yurec-orl/Niva_dashboard_rpi/niva_dashboard/src/hardware/sensor_manager.rs

//! Sensor Manager implements a sensor management system using a chain-of-responsibility
//! pattern to handle sensor data from raw hardware inputs to logical values.
//!
//! The system is built around three-stage processing chains:
//!
//! Hardware Provider → Signal Processors → Logical Sensor
//!     (Raw Data)      (Filtering/Smoothing)  (Value Conversion)
//!
//! ### Components
//!
//! 1. **Hardware Providers** (`HWDigitalProvider`/`HWAnalogProvider`)
//!    - Abstract hardware interface layer
//!    - Read raw sensor data from GPIO pins, I2C devices, or test data
//!    - Return unprocessed digital levels (High/Low) or analog values (u16)
//!
//! 2. **Signal Processors** (`DigitalSignalProcessor`/`AnalogSignalProcessor`)
//!    - Pipeline of configurable processing stages
//!    - Digital: debouncing, edge detection, state smoothing
//!    - Analog: moving averages, low-pass filtering, noise reduction
//!    - Multiple processors can be chained for complex signal conditioning
//!
//! 3. **Logical Sensors** (`DigitalSensor`/`AnalogSensor`)
//!    - Convert processed signals to meaningful values
//!    - Digital: map to boolean states (active/inactive) considering polarity
//!    - Analog: convert to physical units (voltage → temperature, ADC → fuel level)
//!
//! ### Sensor Chains
//!
//! **SensorDigitalInputChain**: Hardware → [Processors] → Digital Sensor → bool
//! - Example: GPIO pin → debounce → active-low interpretation → brake_engaged
//!
//! **SensorAnalogInputChain**: Hardware → [Processors] → Analog Sensor → f32
//! - Example: ADC → moving average → voltage divider math → fuel_percentage
//!
//! ### SensorManager
//!
//! - Maintains collections of configured sensor chains
//! - Routes read requests to appropriate chains by input type
//! - Executes the full processing pipeline for each sensor read
//! - Returns processed, ready-to-display values to the UI layer
//!
//! ### Usage
//!
//! ```rust
//! let mut manager = SensorManager::new();
//! 
//! // Configure a digital sensor chain
//! let chain = SensorDigitalInputChain::new(
//!     Box::new(gpio_provider),
//!     vec![Box::new(debouncer)],
//!     Box::new(active_low_sensor)
//! );
//! manager.add_digital_sensor_chain(chain);
//! 
//! // Read processed sensor value
//! let brake_active = manager.read_digital_sensor(HWInput::ParkBrake(Level::Low))?;
//! ```

use crate::hardware::sensors::{AnalogSensor, DigitalSensor};
use crate::hardware::hw_providers::{HWInput, HWAnalogProvider, HWDigitalProvider, ADCChannelProvider};
use crate::hardware::analog_signal_processing::AnalogSignalProcessor;
use crate::hardware::digital_signal_processing::DigitalSignalProcessor;
use crate::hardware::sensor_value::SensorValue;
use crate::util::adc_data_provider::ADCFrame;

use std::collections::HashMap;

// Sensor management - chains hardware providers, signal processors, and logical sensors
pub struct SensorDigitalInputChain {
    hw_provider: Box<dyn HWDigitalProvider + Send>,
    // Signal processors are applied in sequence
    signal_processors: Vec<Box<dyn DigitalSignalProcessor + Send>>,
    sensor: Box<dyn DigitalSensor + Send>,
}

impl SensorDigitalInputChain {
    pub fn new(
        hw_provider: Box<dyn HWDigitalProvider + Send>,
        signal_processors: Vec<Box<dyn DigitalSignalProcessor + Send>>,
        sensor: Box<dyn DigitalSensor + Send>,
    ) -> Self {
        SensorDigitalInputChain {
            hw_provider,
            signal_processors,
            sensor,
        }
    }
}

// Analog sensor input chain, similar to SensorDigitalInputChain
pub struct SensorAnalogInputChain {
    hw_provider: Box<dyn HWAnalogProvider + Send>,
    // Signal processors are applied in sequence
    signal_processors: Vec<Box<dyn AnalogSignalProcessor + Send>>,
    sensor: Box<dyn AnalogSensor + Send>,
}

impl SensorAnalogInputChain {
    pub fn new(
        hw_provider: Box<dyn HWAnalogProvider + Send>,
        signal_processors: Vec<Box<dyn AnalogSignalProcessor + Send>>,
        sensor: Box<dyn AnalogSensor + Send>,
    ) -> Self {
        SensorAnalogInputChain {
            hw_provider,
            signal_processors,
            sensor,
        }
    }
}

pub struct SensorManager {
    digital_sensors: Vec<SensorDigitalInputChain>,
    analog_sensors: Vec<SensorAnalogInputChain>,
    sensor_values: HashMap<HWInput, SensorValue>,
    // Optional handle to the shared ADC frame, set by callers whose chains include
    // ADCChannelProviders. Lets adc_link_down() report link status directly from the
    // transport layer rather than through a chain read, since a chain read is exactly
    // what fails (with "channel not in frame") while the link is down.
    adc_frame: Option<ADCFrame>,
}

impl SensorManager {
    pub fn new() -> Self {
        SensorManager {
            digital_sensors: Vec::new(),
            analog_sensors: Vec::new(),
            sensor_values: HashMap::new(),
            adc_frame: None,
        }
    }

    pub fn add_digital_sensor_chain(&mut self, chain: SensorDigitalInputChain) {
        self.digital_sensors.push(chain);
    }

    pub fn add_analog_sensor_chain(&mut self, chain: SensorAnalogInputChain) {
        self.analog_sensors.push(chain);
    }

    /// Inserts a value computed outside any registered chain -- e.g. HeadingFusionSensor,
    /// which reads GnssFrame/Bno085Frame directly rather than through a HWAnalogProvider
    /// (see heading_fusion_sensor.rs for why) -- into the same map every chain-backed
    /// reading lands in, so get_sensor_value/get_sensor_values don't need to know how a
    /// given HWInput's value was produced.
    pub fn set_external_value(&mut self, input: HWInput, value: SensorValue) {
        self.sensor_values.insert(input, value);
    }

    /// Registers the ADC frame this manager's chains read from, so adc_link_down() can
    /// report connectivity. Only needed when chains include ADCChannelProviders.
    pub fn set_adc_frame(&mut self, frame: Option<ADCFrame>) {
        self.adc_frame = frame;
    }

    /// Points every chain whose `HWInput` is ADC-backed (`HWInput::adc_channel().is_some()`
    /// -- the same predicate `ADCChannelProvider::new` itself uses) at a fresh
    /// `ADCChannelProvider` reading `frame` instead of whatever frame it was reading before,
    /// leaving every other chain (UPS, GNSS, BNO085, master warning, link-health,
    /// one-wire-temp) completely untouched.
    ///
    /// This is how bench test mode (`PageManager::toggle_bench_test_mode`) swaps in
    /// synthetic sensor data without rebuilding the manager: call once with a synthetic
    /// settle-mode frame to enter bench mode, and again with the real frame to leave it --
    /// same function, same manager, both directions. Doesn't touch `adc_frame` (see
    /// `set_adc_frame`); callers that want `adc_link_down()` to track the new frame too
    /// must call that separately.
    pub fn redirect_adc_chains(&mut self, frame: ADCFrame) {
        for chain in &mut self.digital_sensors {
            let input = chain.hw_provider.input();
            if input.adc_channel().is_some() {
                chain.hw_provider = Box::new(ADCChannelProvider::new(input, frame.clone()));
            }
        }
        for chain in &mut self.analog_sensors {
            let input = chain.hw_provider.input();
            if input.adc_channel().is_some() {
                chain.hw_provider = Box::new(ADCChannelProvider::new(input, frame.clone()));
            }
        }
    }

    /// True if this manager depends on the ADC link and that link is currently down.
    /// Used by callers to suppress read-error logging for the "channel not in frame"
    /// errors that are the expected, transient result of the ADC being disconnected —
    /// see AdcDataProvider's reconnect loop, which recovers automatically.
    pub fn adc_link_down(&self) -> bool {
        self.adc_frame.as_ref().is_some_and(|frame| frame.is_stale())
    }

    fn read_digital_sensor(&mut self, input: HWInput) -> Result<SensorValue, String> {
        for chain in &mut self.digital_sensors {
            if chain.hw_provider.input() != input {
                continue;
            }
            // Read raw input from hardware provider
            let mut level = chain.hw_provider.read_digital(input)?;
            
            // Process through signal processors
            for processor in &mut chain.signal_processors {
                level = processor.read(level)?;
            }
            
            // Convert to logical sensor value
            return Ok(chain.sensor.read(level)?.clone());
        }
        Err(format!("Digital sensor chain not found for input: {:?}", input))
    }

    fn read_analog_sensor(&mut self, input: HWInput) -> Result<SensorValue, String> {
        for chain in &mut self.analog_sensors {
            if chain.hw_provider.input() != input {
                continue;
            }
            // Read raw input from hardware provider
            let mut value = chain.hw_provider.read_analog(input)?;
            
            // Process through signal processors
            for processor in &mut chain.signal_processors {
                value = processor.read(value)?;
            }
            
            // Convert to logical sensor value
            return Ok(chain.sensor.read(value)?.clone());
        }
        Err("Analog sensor chain not found".to_string())
    }

    // Should be called periodically from event loop to update all sensors
    //
    // Chains are read independently — one chain failing (e.g. a GNSS field with no current
    // fix, which is routine and can persist indefinitely) must not prevent every other,
    // unrelated chain from updating. Previously this used `?` per read, which aborted the
    // whole cycle on the first failure; since sensor_values is cleared up front, that meant
    // every chain ordered after the failing one lost its value for the entire cycle (see
    // niva_dashboard's GNSS integration, which surfaced this — GNSS chains fail far more
    // routinely than the ADC ones this originally worked fine with).
    pub fn read_all_sensors(&mut self) -> Result<(), String> {
        self.sensor_values.clear();

        // Collect inputs first to avoid borrowing issues
        let digital_inputs: Vec<HWInput> = self.digital_sensors.iter()
            .map(|chain| chain.hw_provider.input())
            .collect();
        let analog_inputs: Vec<HWInput> = self.analog_sensors.iter()
            .map(|chain| chain.hw_provider.input())
            .collect();

        // Last error is reported to the caller (for logging) but never stops the loop —
        // every remaining chain still gets a chance to update sensor_values.
        let mut last_error: Option<String> = None;

        for input in digital_inputs {
            match self.read_digital_sensor(input) {
                Ok(value) => { self.sensor_values.insert(input, value); }
                Err(e) => last_error = Some(e),
            }
        }

        for input in analog_inputs {
            match self.read_analog_sensor(input) {
                Ok(value) => { self.sensor_values.insert(input, value); }
                Err(e) => last_error = Some(e),
            }
        }

        match last_error {
            Some(e) => Err(e),
            None => Ok(()),
        }
    }

    pub fn get_sensor_values(&self) -> &HashMap<HWInput, SensorValue> {
        &self.sensor_values
    }

    pub fn get_sensor_value(&self, input: &HWInput) -> Option<&SensorValue> {
        self.sensor_values.get(input)
    }
}

#[cfg(test)]
mod tests {
    use super::*;
    use crate::hardware::hw_providers::{TestDigitalDataProvider, TestAnalogDataProvider};
    use crate::hardware::digital_signal_processing::DigitalSignalDebouncer;
    use crate::hardware::analog_signal_processing::AnalogSignalProcessorMovingAverage;
    use crate::hardware::sensors::{GenericDigitalSensor, GenericAnalogSensor};
    use crate::hardware::sensor_value::ValueConstraints;
    use crate::util::adc_data_provider::TestADCDataProvider;
    use rppal::gpio::Level;

    /// Always-failing analog provider, standing in for e.g. GnssChannelProvider reading a
    /// field that's simply not present in the current fix yet — a routine, expected failure
    /// mode that must not block unrelated chains from updating.
    struct AlwaysFailingAnalogDataProvider {
        input: HWInput,
    }

    impl crate::hardware::hw_providers::HWAnalogProvider for AlwaysFailingAnalogDataProvider {
        fn input(&self) -> HWInput { self.input }
        fn read_analog(&self, _input: HWInput) -> Result<u16, String> {
            Err("simulated read failure".to_string())
        }
    }
    use std::time::Duration;

    #[test]
    fn test_sensor_manager_digital_chain() {
        log::info!("=== Testing Digital Sensor Chain ===");
        
        let mut manager = SensorManager::new();
        
        // Create test digital input for park brake (active low)
        let park_brake_input = HWInput::HwParkBrake;
        
        // Create digital sensor chain components
        let hw_provider = Box::new(TestDigitalDataProvider::new(park_brake_input));
        let debouncer = Box::new(DigitalSignalDebouncer::new(3, Duration::from_millis(50)));
        let sensor = Box::new(GenericDigitalSensor::new("test_park_brake".to_string(), "Test Park Brake".to_string(), 
                                                        Level::Low, ValueConstraints::digital_warning())); // Active low sensor
        
        // Create and add the chain
        let chain = SensorDigitalInputChain::new(
            hw_provider,
            vec![debouncer],
            sensor,
        );
        manager.add_digital_sensor_chain(chain);
        
        // Test reading the sensor during active period (first 4 seconds)
        let result = manager.read_digital_sensor(park_brake_input);
        assert!(result.is_ok(), "Digital sensor read should succeed");
        
        let sensor_value = result.unwrap();
        log::info!("Park brake active (during active period): {}", sensor_value.is_active());
        
        // In TestDigitalDataProvider, the first 4 seconds return the active level (Low)
        // Since our sensor is active-low, it should read as true (active)
        assert!(sensor_value.is_active(), "Park brake should be active during test period");
        
        log::info!("✓ Digital sensor chain test passed");
    }

    #[test]
    fn test_sensor_manager_analog_chain() {
        log::info!("=== Testing Analog Sensor Chain ===");
        
        let mut manager = SensorManager::new();
        
        // Create test analog input for fuel level
        let fuel_input = HWInput::HwFuelLvl;
        
        // Create analog sensor chain components
        let hw_provider = Box::new(TestAnalogDataProvider::new(fuel_input));
        let moving_avg = Box::new(AnalogSignalProcessorMovingAverage::new(3));
        let sensor = Box::new(GenericAnalogSensor::new(
            "test_fuel".to_string(), "Test Fuel Level".to_string(), "%".to_string(),
            ValueConstraints::analog_with_thresholds(0.0, 100.0, Some(10.0), Some(20.0), None, None),
            1.0
        ));
        
        // Create and add the chain
        let chain = SensorAnalogInputChain::new(
            hw_provider,
            vec![moving_avg],
            sensor,
        );
        manager.add_analog_sensor_chain(chain);
        
        // Test reading the sensor
        let result = manager.read_analog_sensor(fuel_input);
        assert!(result.is_ok(), "Analog sensor read should succeed");
        
        let sensor_value = result.unwrap();
        log::info!("Fuel level: {:.1}%", sensor_value.as_f32());
        
        // Fuel percentage should be between 0 and 100
        let fuel_percentage = sensor_value.as_f32();
        assert!(fuel_percentage >= 0.0 && fuel_percentage <= 100.0, 
               "Fuel percentage should be between 0 and 100");
        
        log::info!("✓ Analog sensor chain test passed");
    }

    /// Always-erroring provider standing in for "whatever provider a real build originally
    /// wired up" -- if `redirect_adc_chains` did nothing, reads would keep failing.
    struct AlwaysErrAnalogProvider(HWInput);
    impl HWAnalogProvider for AlwaysErrAnalogProvider {
        fn input(&self) -> HWInput { self.0 }
        fn read_analog(&self, _input: HWInput) -> Result<u16, String> {
            Err("should have been replaced by redirect_adc_chains".to_string())
        }
    }

    #[test]
    fn test_redirect_adc_chains_only_touches_adc_backed_inputs() {
        let mut manager = SensorManager::new();

        // HwOilPress has an ADC channel mapping (HWInput::adc_channel) -- redirect_adc_chains
        // must replace its provider.
        manager.add_analog_sensor_chain(SensorAnalogInputChain::new(
            Box::new(AlwaysErrAnalogProvider(HWInput::HwOilPress)),
            vec![],
            Box::new(GenericAnalogSensor::new("oil".to_string(), "Oil".to_string(), "".to_string(),
                ValueConstraints::analog(0.0, 1023.0), 1.0)),
        ));
        // HwGnssSpeed has no ADC channel mapping -- must be left completely alone.
        manager.add_analog_sensor_chain(SensorAnalogInputChain::new(
            Box::new(TestAnalogDataProvider::new(HWInput::HwGnssSpeed)),
            vec![],
            Box::new(GenericAnalogSensor::new("gnss".to_string(), "GNSS".to_string(), "".to_string(),
                ValueConstraints::analog(0.0, 200.0), 1.0)),
        ));

        let provider = TestADCDataProvider::start();
        let frame = provider.frame();
        std::thread::sleep(Duration::from_millis(50));

        manager.redirect_adc_chains(frame);

        assert!(manager.read_analog_sensor(HWInput::HwOilPress).is_ok(),
            "ADC-backed chain must now read through the new frame instead of erroring");
        assert!(manager.read_analog_sensor(HWInput::HwGnssSpeed).is_ok(),
            "non-ADC-backed chain must be untouched (still its own TestAnalogDataProvider)");
    }

    #[test]
    fn test_sensor_manager_multiple_chains() {
        log::info!("=== Testing Multiple Sensor Chains ===");
        
        let mut manager = SensorManager::new();
        
        // Add digital chain for high beam indicator (active high)
        let high_beam_input = HWInput::HwHighBeam;
        let digital_chain = SensorDigitalInputChain::new(
            Box::new(TestDigitalDataProvider::new(high_beam_input)),
            vec![], // No signal processing for this test
            Box::new(GenericDigitalSensor::new("test_high_beam".to_string(), "Test High Beam".to_string(),
                                              Level::High, ValueConstraints::digital_default())), // Active high sensor
        );
        manager.add_digital_sensor_chain(digital_chain);
        
        // Add analog chain for temperature
        let temp_input = HWInput::HwEngineCoolantTemp;
        let analog_chain = SensorAnalogInputChain::new(
            Box::new(TestAnalogDataProvider::new(temp_input)),
            vec![Box::new(AnalogSignalProcessorMovingAverage::new(5))],
            Box::new(GenericAnalogSensor::new(
                "test_temp".to_string(), "Test Temperature".to_string(), "°C".to_string(),
                ValueConstraints::analog_with_thresholds(-40.0, 120.0, Some(-20.0), Some(0.0), Some(100.0), Some(110.0)),
                1.0
            )),
        );
        manager.add_analog_sensor_chain(analog_chain);
        
        // Test both sensors
        let high_beam_result = manager.read_digital_sensor(high_beam_input);
        let temp_result = manager.read_analog_sensor(temp_input);
        
        assert!(high_beam_result.is_ok(), "High beam sensor should work");
        assert!(temp_result.is_ok(), "Temperature sensor should work");
        
        let high_beam_sensor_value = high_beam_result.unwrap();
        let temp_sensor_value = temp_result.unwrap();
        
        log::info!("High beam active: {}", high_beam_sensor_value.is_active());
        log::info!("Temperature: {:.1}°C", temp_sensor_value.as_f32());
        
        // Validate ranges
        let temperature = temp_sensor_value.as_f32();
        assert!(temperature >= -40.0 && temperature <= 120.0, 
               "Temperature should be within sensor range");
        
        log::info!("✓ Multiple sensor chains test passed");
    }

    #[test]
    fn test_sensor_manager_nonexistent_chain() {
        log::info!("=== Testing Non-existent Sensor Chain ===");
        
        let mut manager = SensorManager::new();
        
        // Try to read from a sensor that wasn't configured
        let non_existent_input = HWInput::HwSpeed;
        let result = manager.read_digital_sensor(non_existent_input);
        
        assert!(result.is_err(), "Reading non-existent sensor should fail");
        
        let error_msg = result.unwrap_err();
        log::error!("Expected error: {}", error_msg);
        assert!(error_msg.contains("Digital sensor chain not found"), 
               "Error should indicate missing chain");
        
        log::info!("✓ Non-existent sensor chain test passed");
    }

    #[test] 
    fn test_sensor_manager_signal_processing_pipeline() {
        log::info!("=== Testing Signal Processing Pipeline ===");
        
        let mut manager = SensorManager::new();
        
        // Create a chain with multiple signal processors
        let turn_signal_input = HWInput::HwTurnSignal;
        
        // Add two debounce stages for extra filtering
        let debouncer1 = Box::new(DigitalSignalDebouncer::new(2, Duration::from_millis(25)));
        let debouncer2 = Box::new(DigitalSignalDebouncer::new(2, Duration::from_millis(25)));
        
        let chain = SensorDigitalInputChain::new(
            Box::new(TestDigitalDataProvider::new(turn_signal_input)),
            vec![debouncer1, debouncer2], // Multiple processors in sequence
            Box::new(GenericDigitalSensor::new("test_turn_signal".to_string(), "Test Turn Signal".to_string(),
                                              Level::High, ValueConstraints::digital_default())),
        );
        manager.add_digital_sensor_chain(chain);
        
        // Read the sensor to verify the pipeline works
        let result = manager.read_digital_sensor(turn_signal_input);
        assert!(result.is_ok(), "Signal processing pipeline should work");
        
        let sensor_value = result.unwrap();
        log::info!("Turn signal active (after processing): {}", sensor_value.is_active());
        
        log::info!("✓ Signal processing pipeline test passed");
    }

    #[test]
    fn test_read_all_sensors_one_failing_chain_does_not_block_others() {
        log::info!("=== Testing read_all_sensors resilience to a single chain failure ===");

        let mut manager = SensorManager::new();

        // Ordered first, deliberately, so a pre-fix (abort-on-first-error) read_all_sensors
        // would never even attempt the chain below.
        let failing_chain = SensorAnalogInputChain::new(
            Box::new(AlwaysFailingAnalogDataProvider { input: HWInput::HwGnssMovingHeading }),
            vec![],
            Box::new(GenericAnalogSensor::new("failing".to_string(), "Failing".to_string(), "".to_string(),
                                              ValueConstraints::analog(0.0, 100.0), 1.0)),
        );
        manager.add_analog_sensor_chain(failing_chain);

        let working_chain = SensorAnalogInputChain::new(
            Box::new(TestAnalogDataProvider::new(HWInput::HwFuelLvl)),
            vec![],
            Box::new(GenericAnalogSensor::new("working".to_string(), "Working".to_string(), "%".to_string(),
                                              ValueConstraints::analog(0.0, 100.0), 1.0)),
        );
        manager.add_analog_sensor_chain(working_chain);

        let result = manager.read_all_sensors();
        assert!(result.is_err(), "the failing chain's error should still surface");

        assert!(manager.get_sensor_value(&HWInput::HwGnssMovingHeading).is_none(),
               "the failing chain should simply have no value, not poison the cycle");
        assert!(manager.get_sensor_value(&HWInput::HwFuelLvl).is_some(),
               "a chain ordered after a failing one must still be read");

        log::info!("✓ read_all_sensors resilience test passed");
    }

}
