yurec-orl/Niva_dashboard_rpi/(commit log)

2025-08-29 Text renderer cleanup fix
    [context.rs]
2025-08-30 Add input handlers for external keyboard and MFI buttons
2025-08-30 Fix text rendering y coordinate (top line instead of a baseline)
    [context.rs]
2025-08-30 Add current page
2025-08-30 Add button labels rendering
2025-08-31 Add sensors reading framework - WIP
2025-08-31 Use page id for switch_page
2025-09-02 Hardware input reading and processing framework - implementation
2025-09-06 Add sensor manager
2025-09-06 Add sensor manager tests
2025-09-07 Add unit tests, fix compilation errors
    [mod.rs, page_manager.rs, ui_style.rs]
2025-09-07 Replace color manager with UIStyle
    [context.rs, mod.rs, page_manager.rs, ui_style.rs]
2025-09-07 Improve text rendering framework
2025-09-07 Add diag page with page switching
2025-09-12 WIP - indicator rendering framework
2025-09-12 Add basic text indicators using sensors and ui style framework
2025-09-14 WIP: sensor framework refactoring
2025-09-14 Refactor sensors framework - simplified interface, unified digital and analog HWInputs, combined all sensor output values in one vector
2025-09-19 Add constraints and metadata to sensor objects
2025-09-19 Fix unit test compilation errors
    [sensor_manager.rs]
2025-09-19 Add sensors unit tests
2025-09-20 Refactor sensor framework
2025-09-24 Add vertical text orientation for page button labels
2025-09-25 Improve event system - switch to dual-channel
2025-09-27 Add alerts framework (WIP)
2025-09-28 Add alerts framework
2025-12-18 Change watchdogs suppress timers
2025-12-18 Improve button labels rendering (fix #5)
    [page_manager.rs]
2025-12-18 Add indicator position tests (fix #6)
    [hw_providers.rs, main.rs, opengl_test.rs, run_test.rs]
2026-03-14 Add sketch for Arduino ADC module
2026-03-14 Add buttons reading to arduino module
2026-03-15 Add pin mapping for STM32 based ADC-sensor module
2026-03-15 Add wiring doc
2026-05-24 Refactor ui style framework and brightness handling
2026-05-24 Remove manual frame timing, fix rendered vsync bug
    [context.rs, page_manager.rs]
2026-05-30 Update STM32 module
2026-06-09 Add ADC module firmware
2026-06-14 Fix gl buffers leak
    [context.rs, opengl_test.rs, page_manager.rs, run_test.rs]
2026-06-14 Fix gauge marks horisontal position
    [opengl_test.rs, page_manager.rs]
2026-06-14 Add script for testing ADC output
2026-06-21 Add sensor manager swapping, improve adc_data_provider
    [adc_data_provider.rs, adc_serial_reader.rs, events.rs, main.rs, page_manager.rs, sensor_manager.rs]
2026-06-21 Add ADC hardware sensors and manager
2026-07-04 Add shutdown handling and auto-restart on errors or rebuild
    [input.rs, main.rs, mod.rs, page_manager.rs, shutdown.rs]
2026-07-04 Add button backlight redesign plan
2026-07-12 Fix buttons pin mapping
    [main.cpp]
2026-07-12 Add physical buttons input handling from ADC module
2026-07-12 Add ADC link error alert
    [adc_data_provider.rs, adc_serial_reader.rs, hw_providers.rs, main.rs, page_manager.rs]
2026-07-12 Add ADC serial port reconnect
2026-07-12 Add power-cycling ADC module if its unresponsive
2026-07-12 Add automatic shutdown/startup from external power
2026-07-12 Fix alerts suppression logic
    [page_manager.rs]
2026-07-22 Display UPS charge/discharge current
2026-07-22 Add scrolling text box renderer and program log/adc data display
2026-07-22 Add UPS charge level, change status font
2026-07-28 Add on battery power log message
2026-07-28 Add reboot button to diag page
    [diag_page.rs, page_manager.rs, ups_monitor.rs]
2026-07-28 Refactor ups monitor to use sensors framework; add ups alerts
2026-07-29 Add gnss sensors
2026-07-30 Add speed sensor averaging
2026-08-01 Replace speed pulse counting with time between pulses counting
    [main.cpp]
2026-08-01 Replace tacho pulse counting with period counting
    [main.cpp]
2026-08-01 Change on battery threshold
2026-08-01 Fix tachometer sensor
2026-08-01 Refactor adc channels numbering
2026-08-01 Refactor adc provider construction
2026-08-01 Fix speed and tacho sensors
    [sensors.rs]
2026-08-08 Add BNO085 support and gnss/bno085 sensors test mode
2026-08-09 Add fused heading provider for gnss page heading indicator
2026-08-09 Add fused heading sensor based on inertial and gnss data
2026-08-11 Adjust shutdown timer for ups power off timer
2026-08-12 Add IMU info block to gnss page
2026-08-12 Add button press indication
2026-08-12 Fix heading accuracy indication
    [gnss_page.rs, heading_fusion_sensor.rs]
2026-08-12 Add button press event handling and manual heading override for gnss page
2026-08-13 Rearrange main page buttons
2026-08-13 Add pitch/roll indicators; fix BNO085 pitch direction; fix text height calculations
    [bno085_protocol.rs, context.rs, horz_page.rs, main_page.rs, mod.rs]
2026-08-13 Add calibration to horz page
2026-08-13 Improve pitch roll calibration
2026-08-14 Add OSC mode implementation to STM32
2026-08-14 Add osc mode test; fix STM32 osc firmware bug
    [main.cpp, main.rs, run_test.rs]
2026-08-14 Fix osc volts conversion
    [osc_page.rs]
2026-08-25 Add master warning button/led
2026-08-25 Change heading sensor PersistedPrior handling logic
2026-08-25 Improve BNO085 error handling
    [bno085_protocol.rs]
2026-08-26 Refactor bno frame calibration logic
2026-08-26 Refactor bno/gnss frame link status
2026-08-26 Change test to fail - testing github workflow
    [heading_fusion_sensor.rs]
2026-08-26 Switch CI to ARM64 runner to match Pi's char signedness ABI
    The raw gl:: FFI calls pass byte-string pointers (*const u8) into
    parameters typed *const i8, relying on c_char being unsigned. That
    holds on ARM (the actual deploy target) but not x86_64, so it only
    ever compiled because it was only ever built on the Pi. Running CI
    on ubuntu-24.04-arm matches that ABI and tests the same architecture
    family the dashboard ships on.
2026-08-30 Create temp sensors design
2026-09-06 Add DS18B20 support to ADC
2026-09-06 Add sensors config and data-driven construction
2026-09-06 Add temperature sensors framework
2026-09-06 Improve sensor config error handling
    [main.rs, shutdown.rs]
2026-09-06 Add sensor calibration design doc
2026-09-06 Update sensor calibration design
2026-09-07 Add VoltageDividerSensor
2026-09-07 Fix USB CDC build settings (avoid deadlock on receiving commands - see diagnosis doc)
    [main.cpp]
2026-09-07 Add ADC firmware version report to diag page
2026-09-07 Adjust indicators construction to match sensors
2026-09-07 Calibrate 12V sensor
2026-09-08 Add calibrated sensor and calibration curves for oil, fuel, engine.
2026-09-08 Pin ADCCLK <= 14 MHz on the HSI-fallback clock tree
    When the 8 MHz HSE crystal doesn't start, the stm32duino clock config falls
    back to an HSI-PLL SYSCLK of 48 MHz with PCLK2 = 48 MHz but leaves ADCPRE at
    /2, clocking ADC1 at 24 MHz — ~71% over the STM32F103's 14 MHz maximum,
    which degrades conversion accuracy.
    configure_adc_clock(), called from setup(), selects the smallest ADCPRE
    divisor that keeps ADCCLK within spec for whatever PCLK2 actually booted:
    12 MHz at PCLK2 = 48, 12 MHz at a healthy 72.
    Verified against live $OSCDBG register dumps: rcc_cfgr ADCPRE 00 -> 01,
    adcclk 24 MHz -> 12 MHz. Lowering ADCCLK shifts raw ADC readings slightly,
    so the analog-channel trims in niva_dashboar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
    [main.cpp]
2026-09-08 Pair each main-page indicator with its HWInput explicitly
    Replace the three index-zipped Vecs in IndicatorSet (indicators, inputs,
    indicator_bounds) with a single Vec<IndicatorEntry>, each entry binding one
    indicator to the hardware input that feeds it and its screen bounds. A
    construction reorder can no longer desync the lists.
    The test-indicator setup no longer keeps a standalone 16-element input list in
    lockstep with 16 separate push calls: digital and analog inputs are zipped with
    their indicators at construction, and each analog sensor's decimal precision sits
    next to its own input.
    Closes #17
    [main_page.rs]
2026-09-12 Improve indicators rendering when sensor returns error
    [gnss_page.rs, horz_page.rs, main_page.rs, sensor_value.rs]
2026-09-12 Add sensor calibration framework and UI (single offset value per sensor)
2026-09-12 Add sustained test mode for adc data
2026-09-13 Adjust 12v trim value
2026-09-16 Add tachometer gauge, replace speedometer on main page set 1
    [adc_data_provider.rs, main_page.rs, mod.rs, sensors.rs]
2026-09-16 Add adc frame logging
2026-09-17 Fix analog sensors reading logic
    [adc_data_provider.rs, sensor_config.rs, sensors.rs]
2026-10-01 Add battery monitor (coulometer) preliminary design
2026-10-04 Adjust gnss anchor logic deviation tolerance
    [heading_fusion_sensor.rs]
2026-10-05 Fix heading anchoring logic and test
    [heading_fusion_sensor.rs]
2026-10-05 Nav data log
    [nav_validation.csv]
2026-10-05 Add trip log analysis results
    [nav_validation.csv]
2026-10-10 Add day/night color themes (#40)
    Day theme overrides every color via a "day" section in ui_style.json:
    white background, black text/needles/marks, darker status colors, black
    alerts. Toggled by main page secondary set left button 3, persisted to
    State/config.json.
    Also recolor night needles/critical alerts to bright yellow and warning
    alerts to white, and move remaining hard-coded colors (osc page, GNSS/horz
    text indicators, screen clear) behind style keys.
